VedranBaruncic/scooter-led-controller/images/scooter.jpg

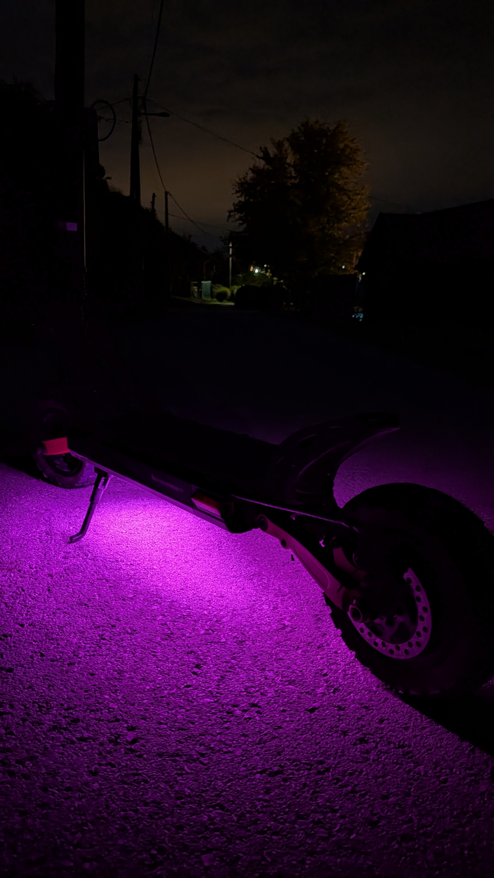
images/scooter.jpg
