VedranBaruncic/scooter-led-controller/(commit log)

2026-09-18 LED Configuration header filled
2026-09-22 Power system and budget
2026-09-23 Update README with power efficiency and charging details
2026-10-08 Enhance README with WS2812B protocol details
    Expanded the README with detailed explanations of WS2812B LED communication, timing requirements, AVR instruction timing, and logical codes for signal generation.
